mike-rankin/ESP8266_OLED_Display/(threads)

Thread 2 (2017-03-31):

Alternative for C1005X5R1C225M050BC

DoinStuff35, 2017-03-31:
Hello!

The C1005X5R1C225M050BC is hard to get over here (Germany). Shipping Cost from Digi-Key about 20 $ :(.

Any alternatives?

Maybe [this item](http://www.ebay.de/itm/10-X-CAP-MLCC-X5R-2-2UF-6-3V-0402-Teil-MURATA-GRM155R60J225ME15D-/272558449752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) ?

Thanks!

mike-rankin, 2017-03-31:
Any 2.2uF 0402 capacitor will work that's 16v.

shownb, 2017-04-01:
@mike-rankin hello,if i want to use a 3.7v lipo battery，do you think which LDO is better?

@DoinStuff35 Hallo,ich bin auch in Deutschland,aber ich bin ein Ausländer.Darf ich deine email adresse haben? ich habe viele Fragen.Z.B ich weiß nicht wo ich Lötzinn oder  Elektronische bauteile kaufen kann.ich warte auf deine antwort.

mike-rankin, 2017-04-01:
Use this LDO:

https://github.com/mike-rankin/ESP8266_OLED_Display/tree/master/PCB

DoinStuff35, 2017-04-01:
Oh man...no 2.2uF 0402 cap with 16V on eBay, nor on any of my"used to" Stores (@shownb: conrad.de, reichelt.de, pollin.de, voelkner.de).

Any suggestions? Any china store? I just don´t want to pay 20$ shipping fee for an 4 cent item :(.

@shownb: Don´t want to share my mail address on public forum, sorry. Is there a kind of PM function on github?

mike-rankin, 2017-04-01:
Here is one: http://s.aliexpress.com/qUvI77jA

DoinStuff35, 2017-04-02:
Thanks Mike. But still no luck:

"This product can't be shipped to the selected region."

This one is driving me crazy...

DoinStuff35, 2017-04-02:
Update:

Didn´t know, that i can use my german ebay account on ebay.com. Different Items available on US ebay. Found a seller delivering worldwide:

http://www.ebay.com/itm/332145911902

Now just have to wait :)

shownb, 2017-04-02:
you can buy it from http://www.rs-components.com
will send from uk

if you buy from the url that you showed, I think it will come from China.

Thread 3 (2017-08-19):

Error uploading sample

backinside, 2017-08-19:
I've just built this, but when I try to upload the wifi scan sample, I get an error:
warning: espcomm_sync failed
error: espcomm_open failed
error: espcomm_upload_mem failed
error: espcomm_upload_mem failed

If I plug the board in, the red led lights up, and the blue led is blinking
If I push the button while plugging in, red led lights up, and the blue stays dark
So I believe the board is in programming mode, but I get the same error message in both cases
These are my board settings:
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

mike-rankin, 2017-08-19:
It sounds like the FTDI is not communicating to the microprocessor.

backinside, 2017-08-20:
I've just managed to get it to work, thanks :)

Closed 2017-08-20.
