mike-rankin/ESP8266_OLED_Display/Code/Icon_Based/Icon_Based.ino

/**The MIT License (MIT)

Copyright (c) 2015 by Daniel Eichhorn

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
See more at http://blog.squix.ch
*/

#include <Wire.h>
#include <Ticker.h>
#include "ssd1306_i2c.h"
#include "icons.h"

//pinmode(0, INPUT);
//digitalWrite(pin, HIGH);
//pinMode(0, INPUT_PULLUP);

#include <ESP8266WiFi.h>
#include "WeatherClient.h"

// Initialize the oled display for address 0x3c
// sda-pin=14 and sdc-pin=12
SSD1306 display(0x3c, 0, 2);
WeatherClient weather;
Ticker ticker;

// this array keeps function pointers to all frames
// frames are the single views that slide from right to left
void (*frameCallbacks[3])(int x, int y) = {drawFrame1, drawFrame2, drawFrame3};

// how many frames are there?
int frameCount = 3;
// on frame is currently displayed
int currentFrame = 0;

// your network SSID (name)
char ssid[] = "YOUR SSID";
// your network password
char pass[] = "YOUR PASSWORD";

// Go to forecast.io and register for an API KEY
String forecastApiKey = "YOUR API KEY";

// Coordinates of the place you want
// weather information for
double latitude = 44.9;
double longitude = -64.1;

// flag changed in the ticker function every 10 minutes
bool readyForWeatherUpdate = true;

void setup() {
  
  
  //pinMode(0, INPUT);
  //digitalWrite(0, HIGH);
  
  //pinMode(2, INPUT);
  //digitalWrite(2, HIGH);
  
  pinMode(0, INPUT_PULLUP);
  pinMode(2, INPUT_PULLUP);
  
  // initialize dispaly
  display.init();
  // set the drawing functions
  display.setFrameCallbacks(3, frameCallbacks);
  // how many ticks does a slide of frame take?
  display.setFrameTransitionTicks(10);

  display.clear();
  display.display();
  
  Serial.begin(115200);
  Serial.println();
  Serial.println();

  // We start by connecting to a WiFi network
  Serial.print("Connecting to ");
  Serial.println(ssid);
  WiFi.begin(ssid, pass);
  
  int counter = 0;
  while (WiFi.status() != WL_CONNECTED) {
    delay(500);
    Serial.print(".");
    display.clear();
    display.drawXbm(34,10, 60, 36, WiFi_Logo_bits);
    drawSpinner(3, counter % 3);
    display.display();
    counter++;
  }
  Serial.println("");
  
  Serial.println("WiFi connected");
  Serial.println("IP address: ");
  Serial.println(WiFi.localIP());

  // update the weather information every 10 mintues only
  // forecast.io only allows 1000 calls per day
  ticker.attach(60 * 10, setReadyForWeatherUpdate);
}

void loop() {
  if (readyForWeatherUpdate && display.getFrameState() == display.FRAME_STATE_FIX) {
    readyForWeatherUpdate = false;
    weather.updateWeatherData(forecastApiKey, latitude, longitude);  
  }
  display.clear();
  display.nextFrameTick();
  display.display();
}

void setReadyForWeatherUpdate() {
  readyForWeatherUpdate = true;  
}

void drawFrame1(int x, int y) {
   display.setFontScale2x2(false);
   display.drawString(65 + x, 8 + y, "Now");
   display.drawXbm(x+7,y+7, 50, 50, getIconFromString(weather.getCurrentIcon()));
   display.setFontScale2x2(true);
   display.drawString(64+ x, 20 + y, String(weather.getCurrentTemp()) + "C"); 
}

const char* getIconFromString(String icon) {
   //"clear-day, clear-night, rain, snow, sleet, wind, fog, cloudy, partly-cloudy-day, or partly-cloudy-night"
  if (icon == "clear-day") {
    return clear_day_bits;
  } else if (icon == "clear-night") {
    return clear_night_bits;  
  } else if (icon == "rain") {
    return rain_bits;  
  } else if (icon == "snow") {
    return snow_bits;  
  } else if (icon == "sleet") {
    return sleet_bits;  
  } else if (icon == "wind") {
    return wind_bits;  
  } else if (icon == "fog") {
    return fog_bits;  
  } else if (icon == "cloudy") {
    return cloudy_bits;  
  } else if (icon == "partly-cloudy-day") {
    return partly_cloudy_day_bits;  
  } else if (icon == "partly-cloudy-night") {
    return partly_cloudy_night_bits;  
  } 
  return cloudy_bits;
}

void drawFrame2(int x, int y) {
   display.setFontScale2x2(false);
   display.drawString(65 + x, 0 + y, "Today");
   display.drawXbm(x,y, 60, 60, xbmtemp);
   display.setFontScale2x2(true);
   display.drawString(64 + x, 14 + y, String(weather.getCurrentTemp()) + "C");
   display.setFontScale2x2(false);
   display.drawString(66 + x, 40 + y, String(weather.getMinTempToday()) + "C/" + String(weather.getMaxTempToday()) + "C");  

}

void drawFrame3(int x, int y) {
   display.drawXbm(x+7,y+7, 50, 50, getIconFromString(weather.getIconTomorrow()));
   display.setFontScale2x2(false);
   display.drawString(65 + x, 7 + y, "Tomorrow");
   display.setFontScale2x2(true);
   display.drawString(64+ x, 20 + y, String(weather.getMaxTempTomorrow()) + "C");     
}

void drawSpinner(int count, int active) {
  for (int i = 0; i < count; i++) {
    const char *xbm;
    if (active == i) {
       xbm = active_bits;
    } else {
       xbm = inactive_bits;  
    }
    display.drawXbm(64 - (12 * count / 2) + 12 * i,56, 8, 8, xbm);
  }   
}
